namor5772/WeatherStationESP32/(list of files, drawings)

Other design files:
data/WeatherStationESP32_v3.dsn
